Jstn1321/AI-Exoskeleton/BOM.xlsx

Name of Part | In use? | Link | Price | Bought?
Shoulder - Nema 23 50:1 Planetary Gearbox |  | https://www.omc-stepperonline.com/nema-23-closed-loop-stepper-motor-l-78mm-gear-ratio-50-1-high-precision-planetary-gearbox-23hs22-hg50-e1000 | 74.14 | Yes
Shoulder Rotation - Nema 23 20:1 |  | https://www.omc-stepperonline.com/nema-23-closed-loop-stepper-motor-l-77mm-gear-ratio-20-1-high-precision-planetary-gearbox-23hs22-hg20-e1000 | 73.28
Elbow - Nema 23 20:1 |  | https://www.omc-stepperonline.com/nema-23-closed-loop-stepper-motor-l-77mm-gear-ratio-20-1-high-precision-planetary-gearbox-23hs22-hg20-e1000 | 73.28
Forearm rot - Nema 17 20:1 |  | https://www.omc-stepperonline.com/nema-17-closed-loop-stepper-motor-l-39mm-gear-ratio-20-1-high-precision-planetary-gearbox-17hs15-hg20-e1000 | 55.75
Wrist Rot - Nema 17 20:1 |  | https://www.omc-stepperonline.com/nema-17-closed-loop-stepper-motor-l-39mm-gear-ratio-20-1-high-precision-planetary-gearbox-17hs15-hg20-e1000 | 55.75
Shoulder Bearing - LM104949/11 * 2 |  | https://www.amazon.com/dp/B0B5XQK5H1?ref=ppx_yo2ov_dt_b_fed_asin_title&th=1 | 31.58 | Yes
Shoulder Rot Bearing - SET37 * 2 |  | https://www.amazon.com/Timken-SET37-Tapered-Roller-Bearing/dp/B000BZ6YEK?s=industrial | 35.36 | Yes
Elbow Bearing - 2788/2720 * 2 |  | https://www.amazon.com/uxcell-Tapered-Roller-Bearing-Width/dp/B0B5XQX2RD | 22.49 | Yes
Forearm Bearing - 6812-2RS |  | https://www.amazon.com/uxcell-6806-2RS-Groove-Bearings-Double/dp/B082PSBTLP | 14.09 | Yes
Wrist Bearing - 6706-2RS |  | https://www.amazon.com/uxcell-6806-2RS-Groove-Bearings-Double/dp/B082PS9PHD | 8.49 | Yes
Shoulder Rot Belt - 6484K701 |  | https://www.mcmaster.com/6484K701/ | 18.62 | Yes
Limit switches |  | https://www.amazon.com/JANDECCN-Switch-Straight-Action-V-153-1C25/dp/B09SWCJ8FF | 9.99
Position Tracker - BNO055 |  | https://www.amazon.com/Adafruit-Absolute-Orientation-Fusion-Breakout/dp/B017PEIGIG | 42.14
Teensy 4.1 |  | https://www.amazon.com/PJRC-Teensy-4-1-with-Pins/dp/B08CTM3279?s=electronics | 44.15 | Yes
Teensy 4.1 Breakout Board |  | https://www.amazon.com/Terminal-Breakout-Module-Teensy-Version/dp/B08R7P8G9X | 23.9 | Yes
