Jstn1321/AI-Exoskeleton/CAD Models/Back/InnerBearingShaft.SLDPRT

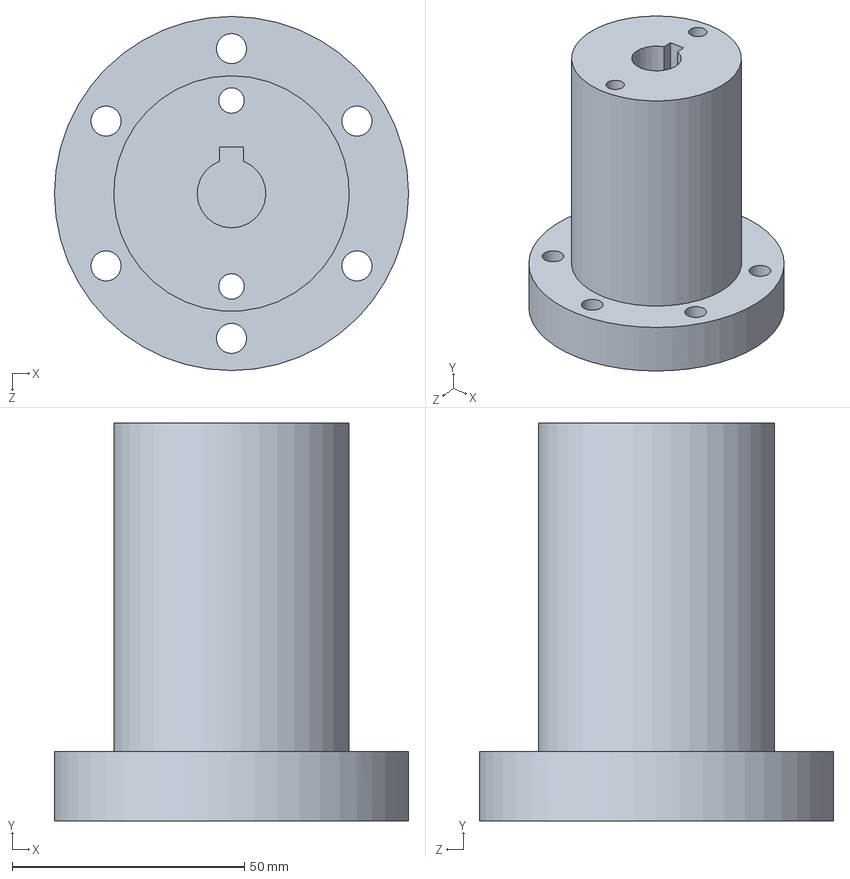
[picture p1: CAD file, 2025-07-13]
CAD Models/Back/InnerBearingShaft.SLDPRT
76.2 x 85.6 x 76.2 mm
