Jstn1321/AI-Exoskeleton/CAD Models/Elbow/MotorElbowCap.SLDPRT

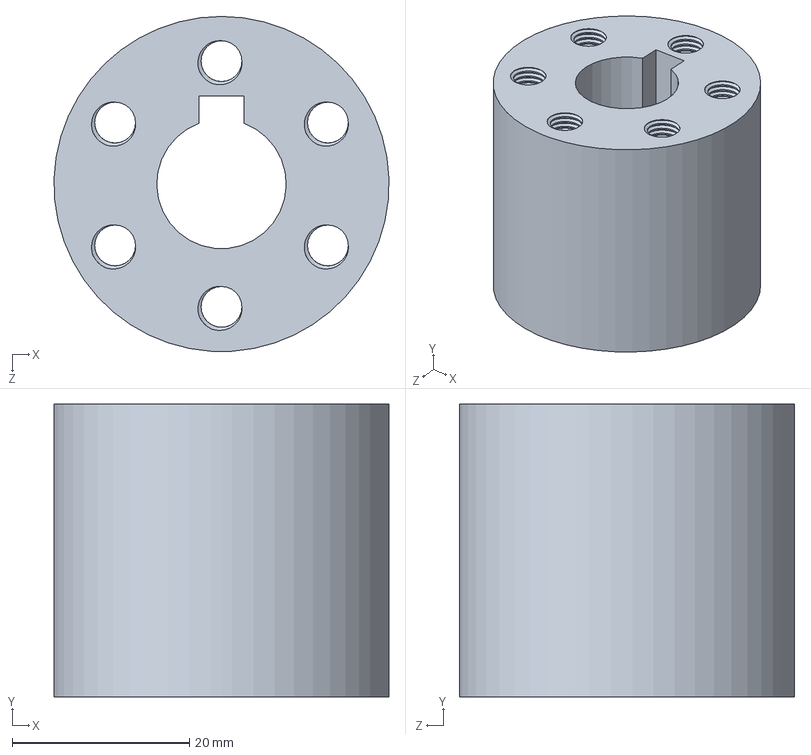
[picture p2: CAD file, 2025-09-02]
CAD Models/Elbow/MotorElbowCap.SLDPRT
37.8 x 33.0 x 37.8 mm
