Jstn1321/AI-Exoskeleton/CAD Models/Forearms/BottomHalfOfForearm.SLDPRT

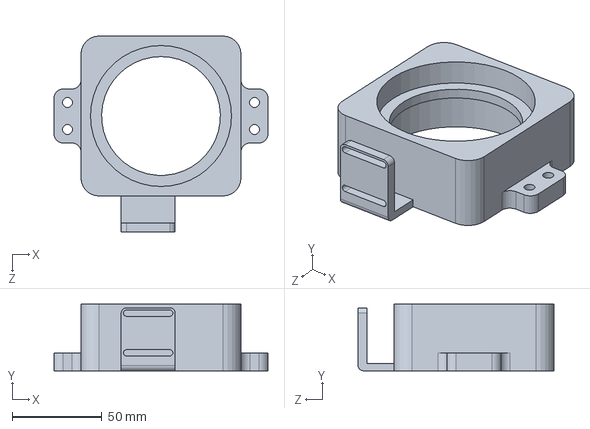
[picture p3: CAD file, 2025-07-11]
CAD Models/Forearms/BottomHalfOfForearm.SLDPRT
118.9 x 37.0 x 108.9 mm
