Jstn1321/AI-Exoskeleton/CAD Models/Hand/Hand.SLDPRT

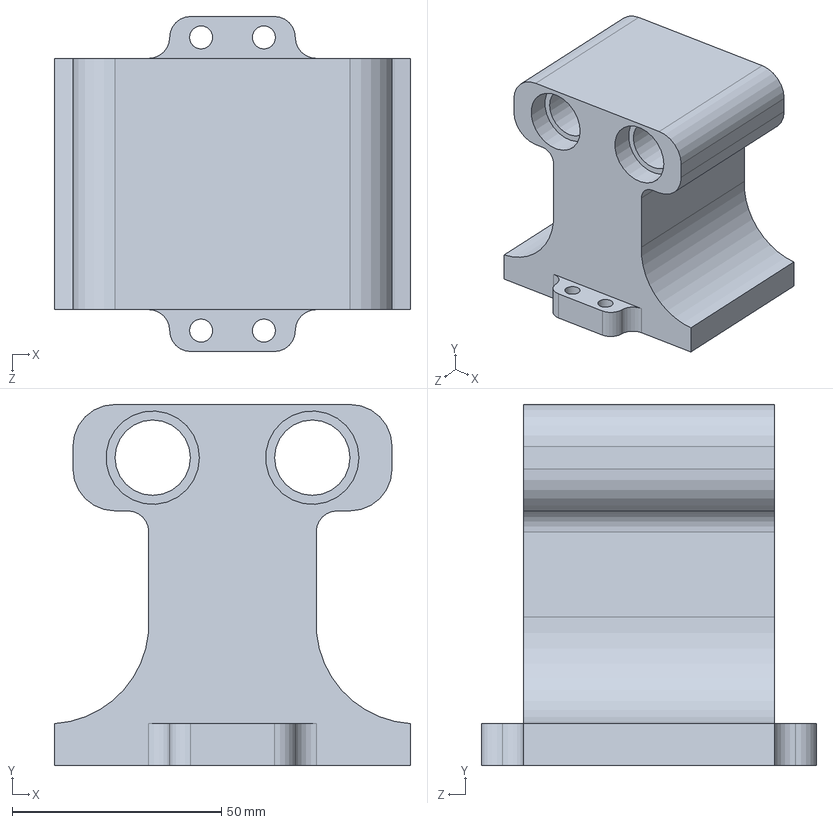
[picture p4: CAD file, 2025-07-19]
CAD Models/Hand/Hand.SLDPRT
85.0 x 86.2 x 80.0 mm
