Jstn1321/AI-Exoskeleton/CAD Models/Misc/LimitSwitchThread.SLDPRT

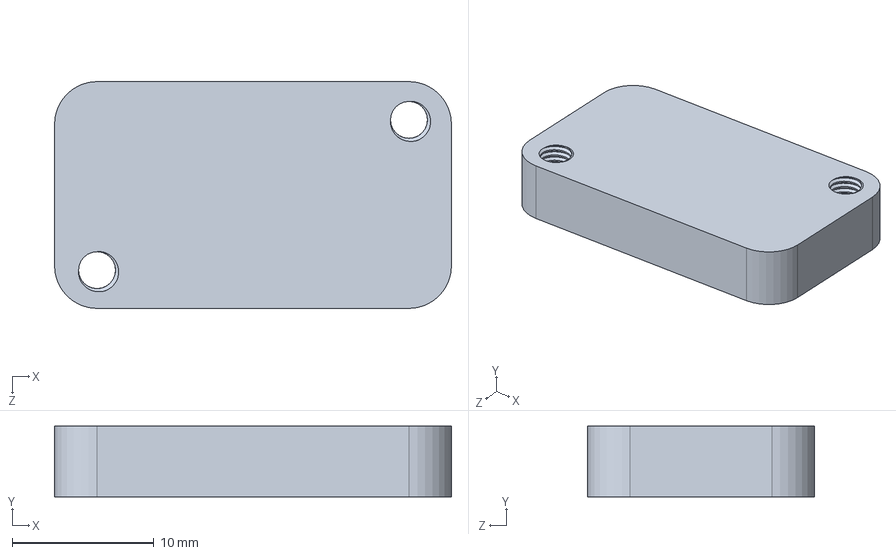
[picture p5: CAD file, 2025-07-05]
CAD Models/Misc/LimitSwitchThread.SLDPRT
28.0 x 5.00 x 16.0 mm
