Jstn1321/AI-Exoskeleton/CAD Models/Shoulder/OuterBearingShaft.SLDPRT

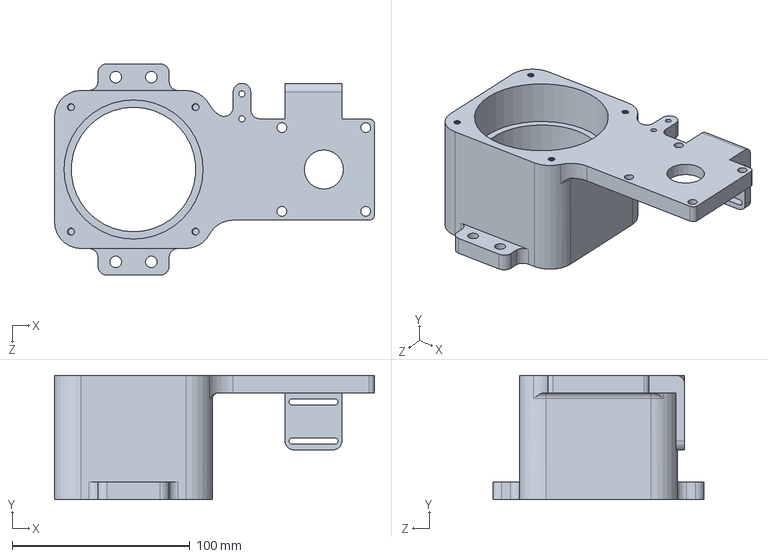
[picture p6: CAD file, 2025-08-18]
CAD Models/Shoulder/OuterBearingShaft.SLDPRT
180.0 x 70.0 x 118.9 mm
