Jstn1321/AI-Exoskeleton/CAD Models/Wrist/Wrist.SLDPRT

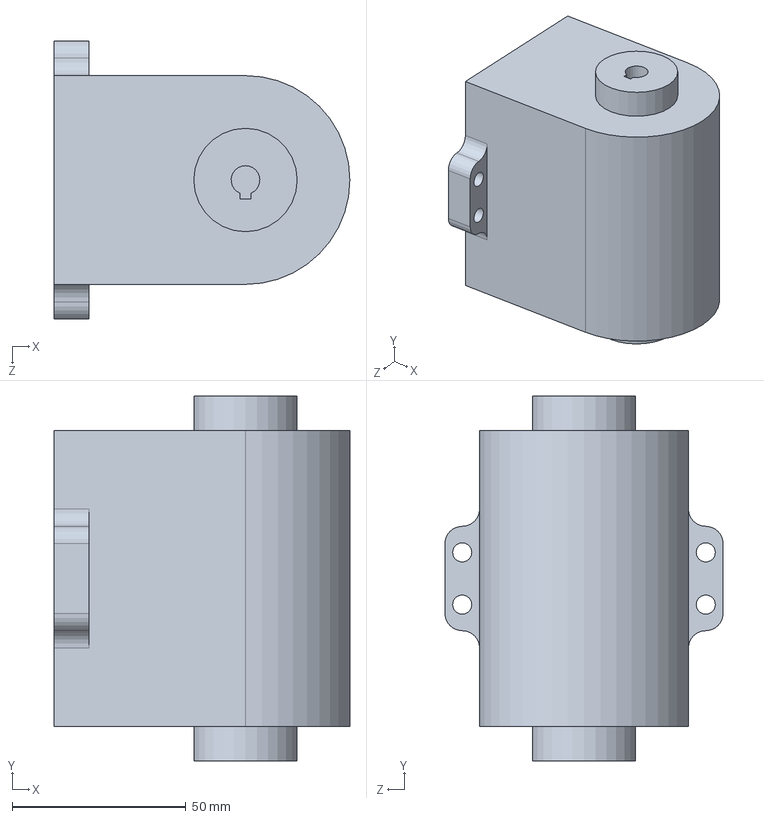
[picture p7: CAD file, 2025-07-11]
CAD Models/Wrist/Wrist.SLDPRT
85.0 x 104.9 x 80.0 mm
