Jstn1321/AI-Exoskeleton/CAD Models/Back/ShoulderMount.SLDPRT

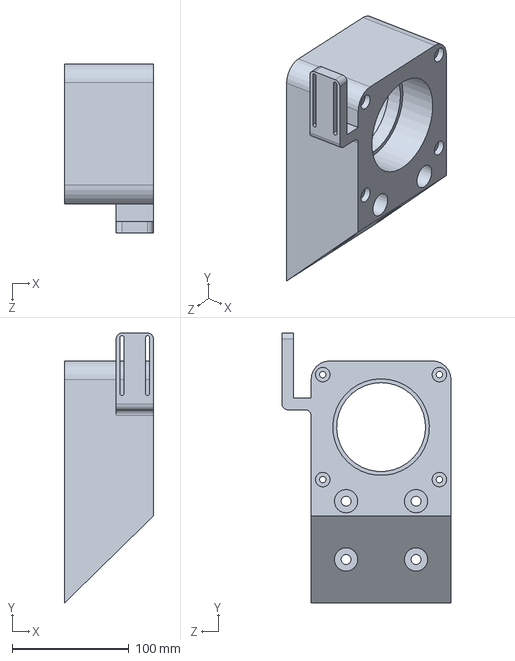
[picture p8: CAD file, 2025-07-01]
CAD Models/Back/ShoulderMount.SLDPRT
76.2 x 231.5 x 145.0 mm
