Jstn1321/AI-Exoskeleton/CAD Models/Elbow/ElbowJointHolderSLDPRT.SLDPRT

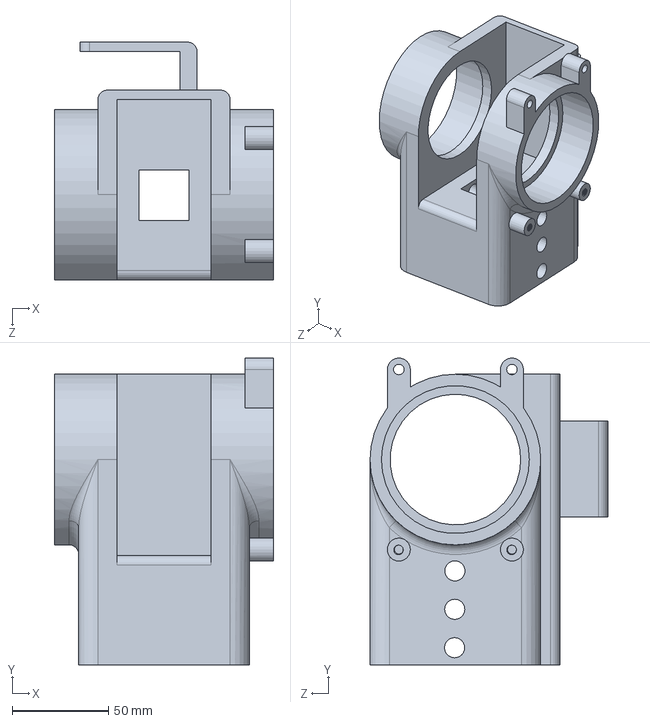
[picture p9: CAD file, 2025-08-29]
CAD Models/Elbow/ElbowJointHolderSLDPRT.SLDPRT
114.3 x 159.9 x 123.9 mm
