Jstn1321/AI-Exoskeleton/CAD Models/Forearms/UpperHalfOfForearm.SLDPRT

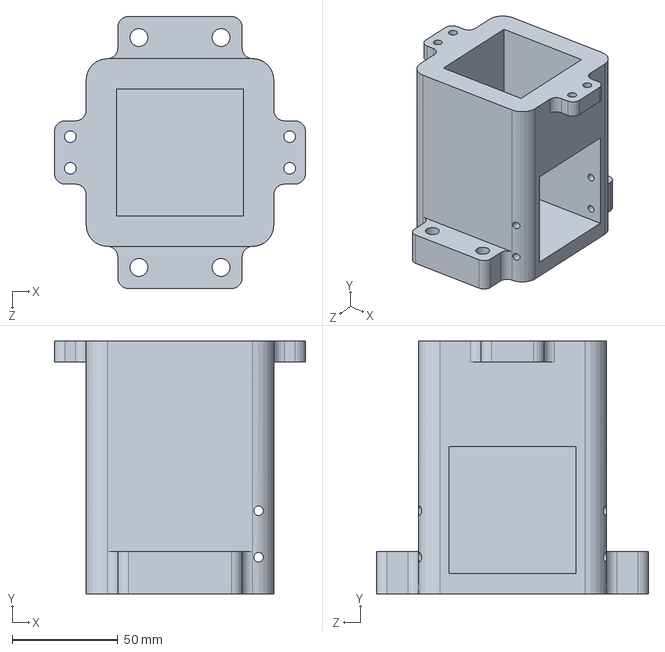
[picture p10: CAD file, 2025-07-11]
CAD Models/Forearms/UpperHalfOfForearm.SLDPRT
118.9 x 119.8 x 128.9 mm
