Jstn1321/AI-Exoskeleton/CAD Models/Shoulder/OuterTensionerRing.SLDPRT

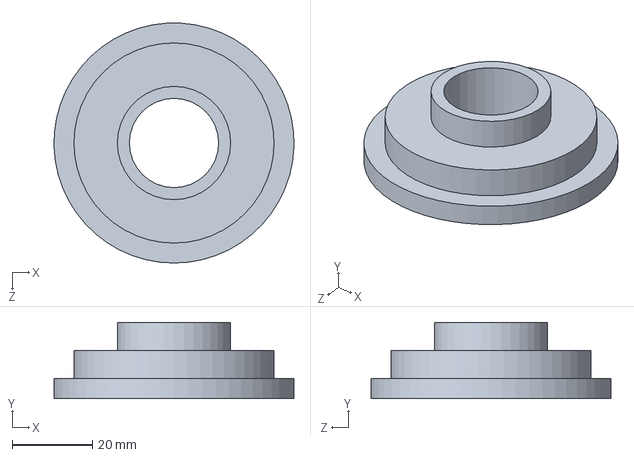
[picture p11: CAD file, 2025-08-03]
CAD Models/Shoulder/OuterTensionerRing.SLDPRT
60.0 x 19.0 x 60.0 mm
