Jstn1321/AI-Exoskeleton/CAD Models/Wrist/WristMotorMount.SLDPRT

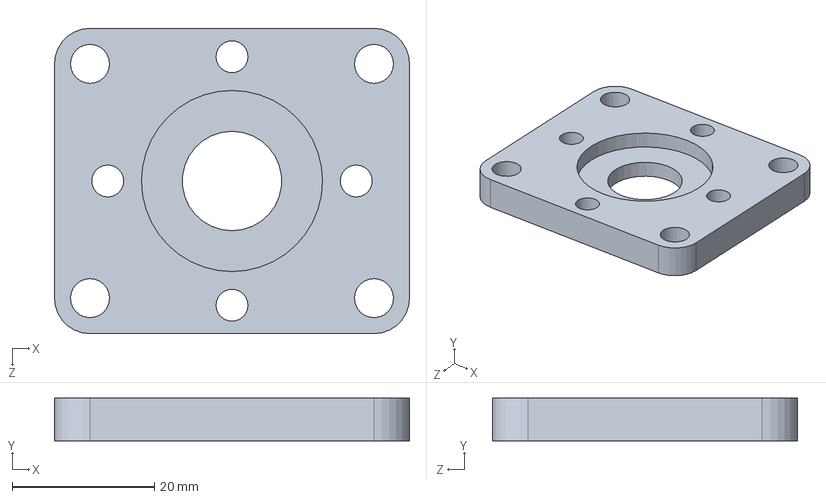
[picture p12: CAD file, 2025-07-11]
CAD Models/Wrist/WristMotorMount.SLDPRT
50.0 x 6.00 x 43.0 mm
