Jstn1321/AI-Exoskeleton/CAD Models/Back/ShoulderLock.SLDPRT

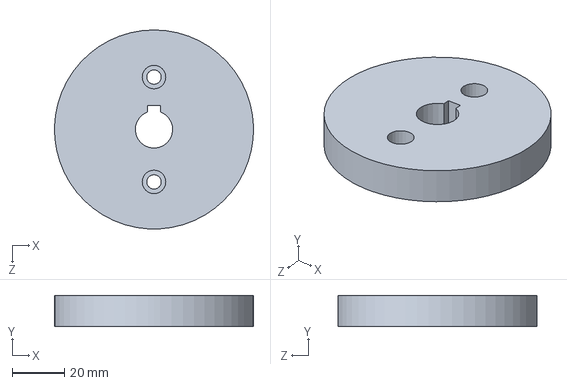
[picture p13: CAD file, 2025-06-28]
CAD Models/Back/ShoulderLock.SLDPRT
76.0 x 12.0 x 76.0 mm
