Jstn1321/AI-Exoskeleton/CAD Models/Elbow/ElbowJoint.SLDPRT

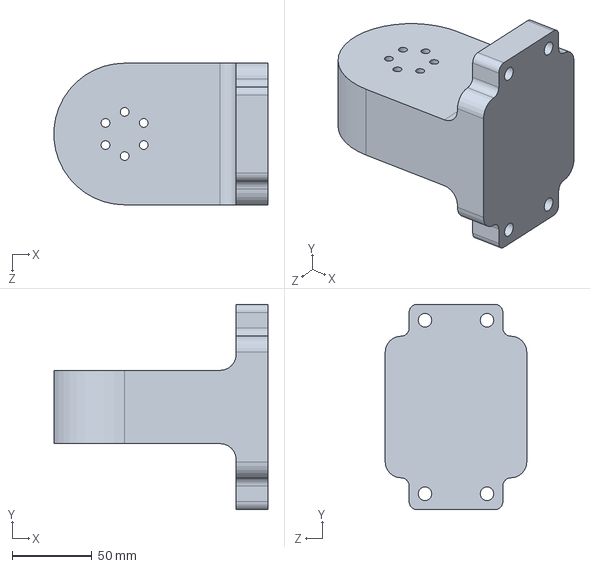
[picture p14: CAD file, 2025-07-11]
CAD Models/Elbow/ElbowJoint.SLDPRT
134.3 x 128.9 x 88.9 mm
