Jstn1321/AI-Exoskeleton/CAD Models/Forearms/InnerShaft.SLDPRT

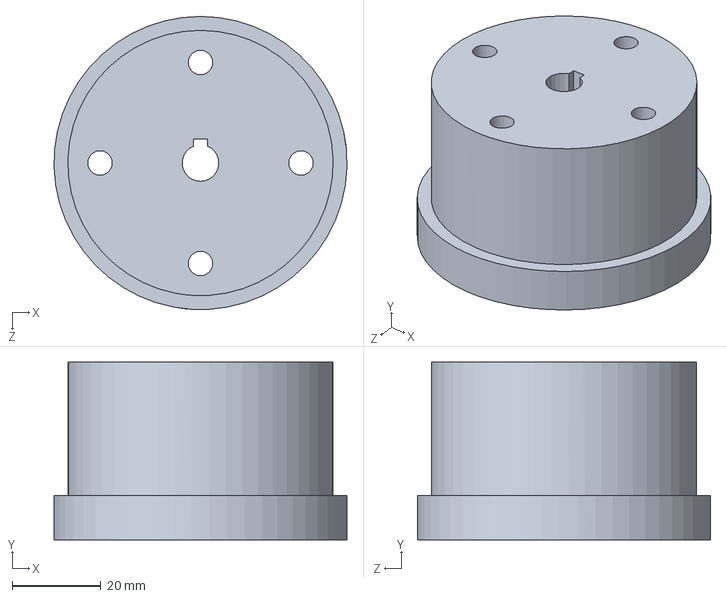
[picture p15: CAD file, 2025-06-27]
CAD Models/Forearms/InnerShaft.SLDPRT
66.0 x 40.0 x 66.0 mm
