Jstn1321/AI-Exoskeleton/CAD Models/Shoulder/GearForMotorShoulderRot.SLDPRT

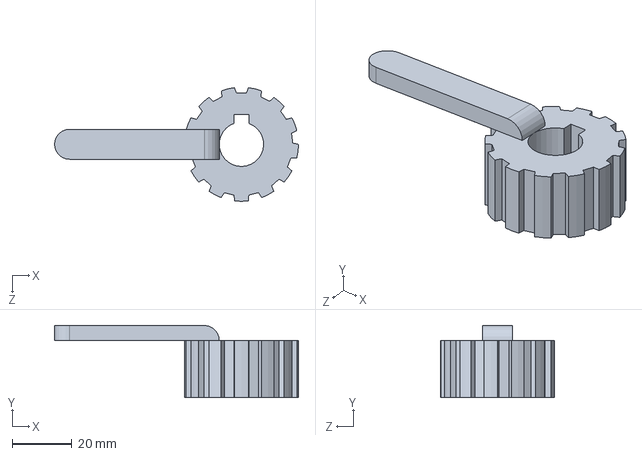
[picture p16: CAD file, 2025-07-13]
CAD Models/Shoulder/GearForMotorShoulderRot.SLDPRT
81.4 x 24.0 x 38.0 mm
