Jstn1321/AI-Exoskeleton/CAD Models/Wrist/MotorSideBearingHolder.SLDPRT

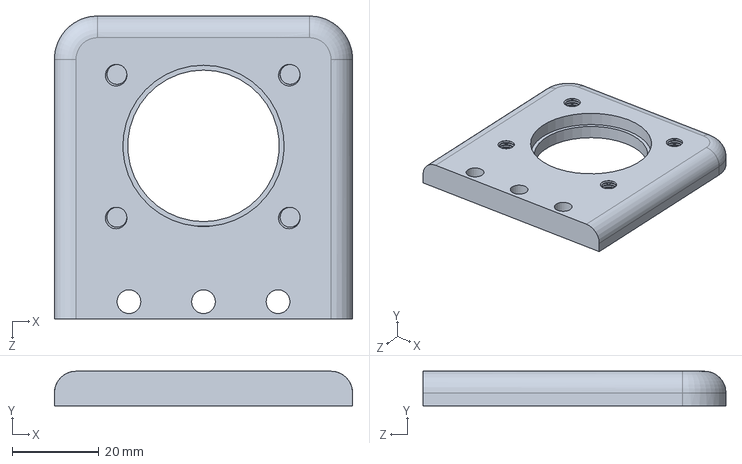
[picture p17: CAD file, 2025-07-11]
CAD Models/Wrist/MotorSideBearingHolder.SLDPRT
68.9 x 8.00 x 70.0 mm
