Jstn1321/AI-Exoskeleton/CAD Models/Back/ShoulderMotorAdaptor.SLDPRT

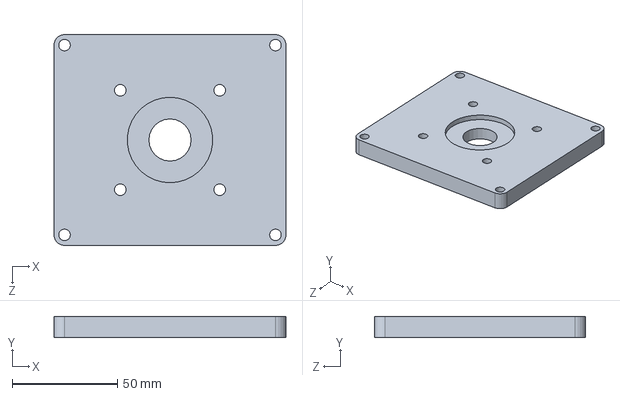
[picture p18: CAD file, 2025-05-29]
CAD Models/Back/ShoulderMotorAdaptor.SLDPRT
110.0 x 10.0 x 100.0 mm
