Jstn1321/AI-Exoskeleton/CAD Models/Elbow/NonMotorElbowCap.SLDPRT

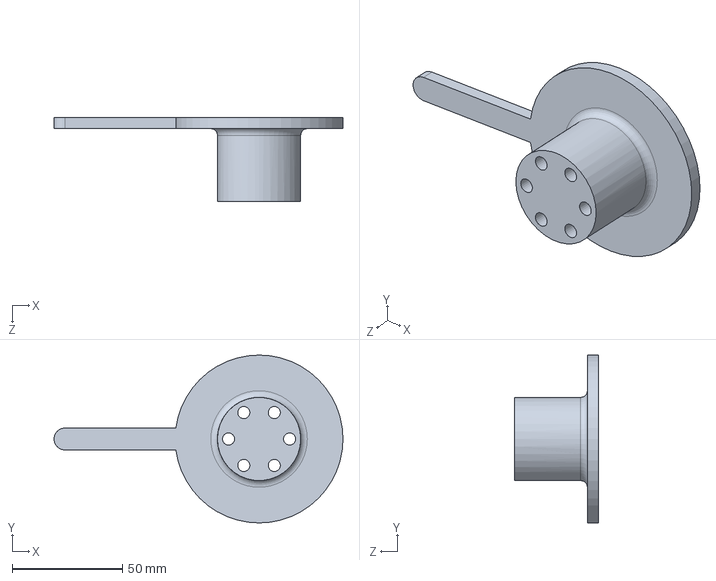
[picture p19: CAD file, 2025-07-06]
CAD Models/Elbow/NonMotorElbowCap.SLDPRT
131.2 x 76.2 x 38.0 mm
