Jstn1321/AI-Exoskeleton/CAD Models/Forearms/MotorMountForForearm.SLDPRT

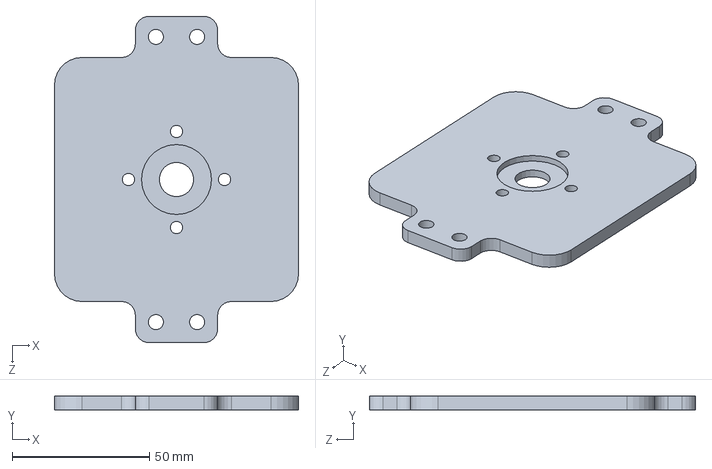
[picture p20: CAD file, 2025-06-26]
CAD Models/Forearms/MotorMountForForearm.SLDPRT
88.9 x 5.00 x 118.9 mm
