Jstn1321/AI-Exoskeleton/CAD Models/Shoulder/GearForShaftShoulderRot.SLDPRT

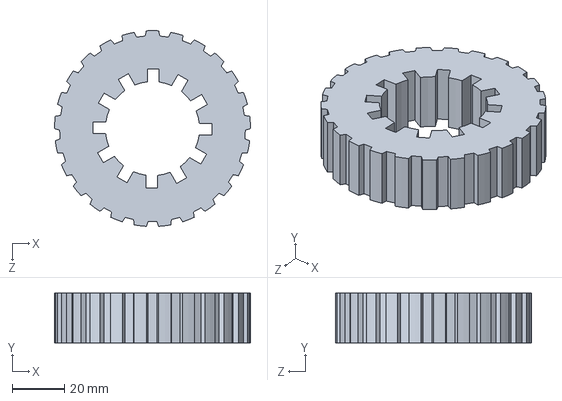
[picture p21: CAD file, 2025-07-13]
CAD Models/Shoulder/GearForShaftShoulderRot.SLDPRT
74.9 x 19.1 x 74.9 mm
