Jstn1321/AI-Exoskeleton/CAD Models/Wrist/LimitSideBearingHolder.SLDPRT

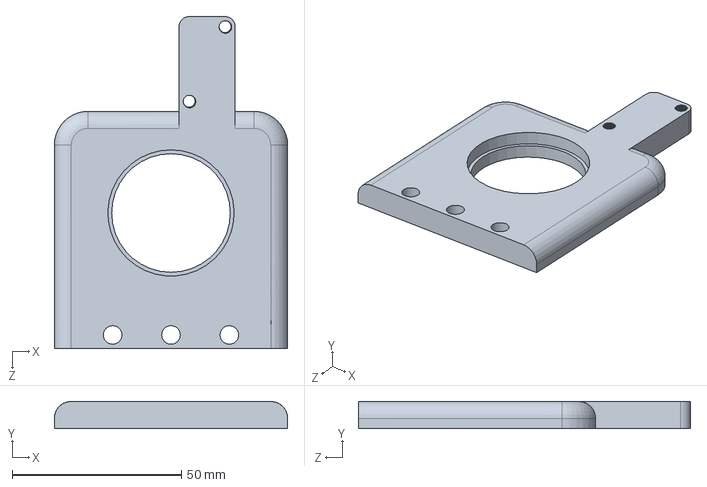
[picture p22: CAD file, 2025-07-11]
CAD Models/Wrist/LimitSideBearingHolder.SLDPRT
68.9 x 8.00 x 98.0 mm
