Jstn1321/AI-Exoskeleton/CAD Models/Back/BackHousing.SLDPRT

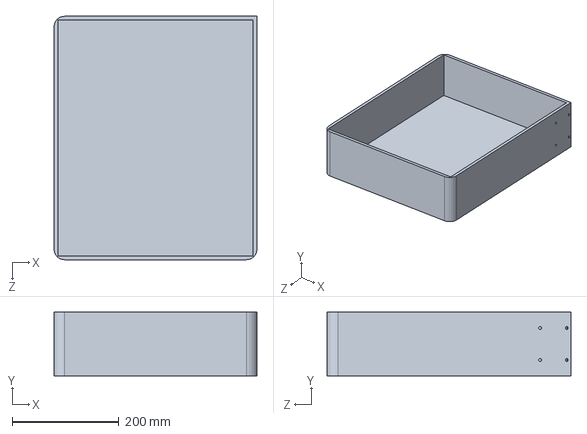
[picture p23: CAD file, 2025-05-29]
CAD Models/Back/BackHousing.SLDPRT
381.0 x 120.0 x 457.2 mm
