Jstn1321/AI-Exoskeleton/CAD Models/Elbow/MotorMount.SLDPRT

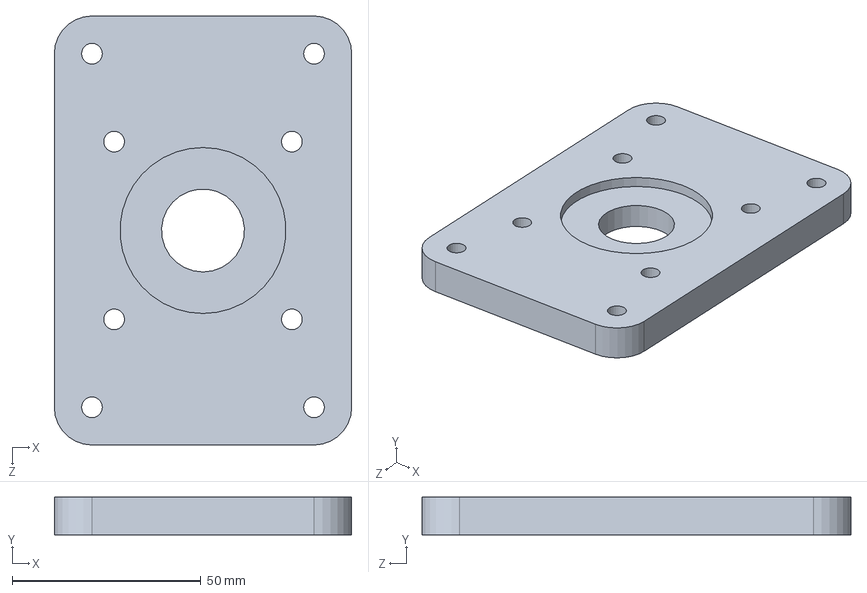
[picture p24: CAD file, 2025-06-17]
CAD Models/Elbow/MotorMount.SLDPRT
78.9 x 10.0 x 113.8 mm
