Jstn1321/AI-Exoskeleton/CAD Models/Shoulder/InnerBearingShaftShoulder.SLDPRT

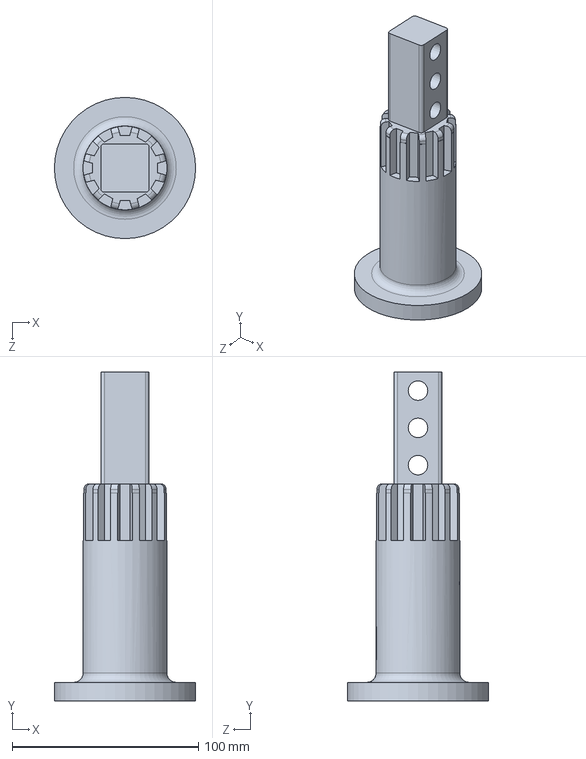
[picture p25: CAD file, 2025-07-08]
CAD Models/Shoulder/InnerBearingShaftShoulder.SLDPRT
75.8 x 176.6 x 75.8 mm
