Jstn1321/AI-Exoskeleton/CAD Models/Wrist/WristHolder.SLDPRT

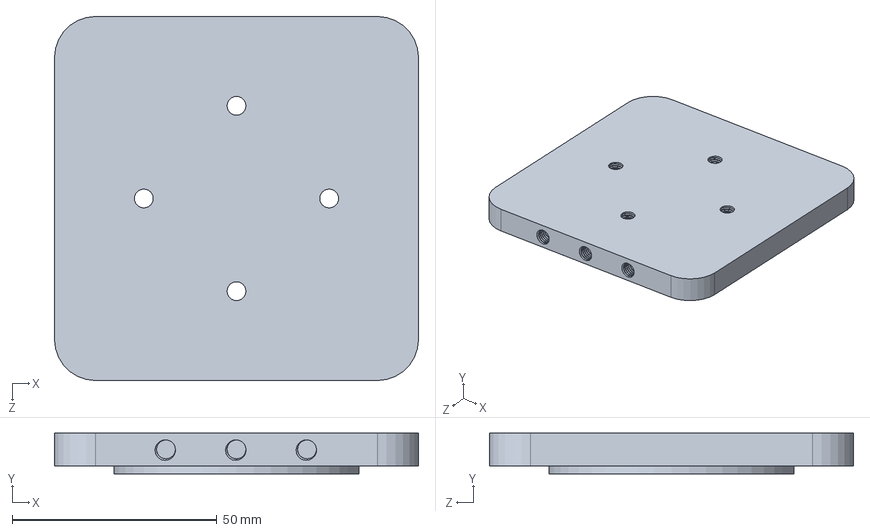
[picture p26: CAD file, 2025-07-11]
CAD Models/Wrist/WristHolder.SLDPRT
88.9 x 10.0 x 88.9 mm
