Jstn1321/AI-Exoskeleton/CAD Models/Shoulder/TopBearingLock.SLDPRT

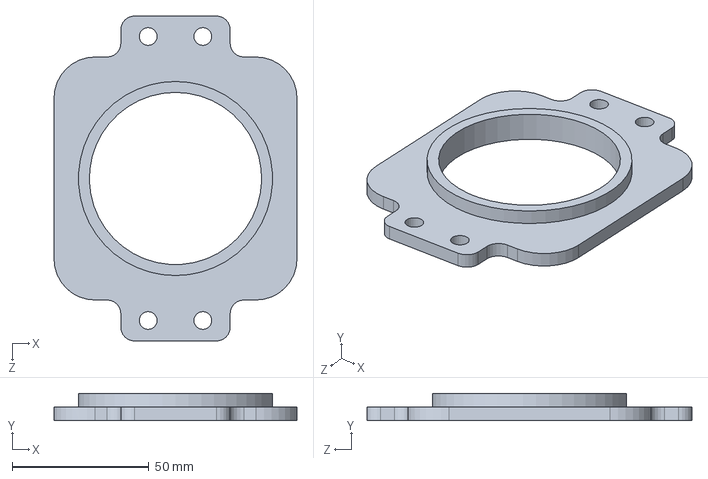
[picture p27: CAD file, 2025-07-07]
CAD Models/Shoulder/TopBearingLock.SLDPRT
88.9 x 10.0 x 118.9 mm
