Jstn1321/AI-Exoskeleton/CAD Models/Wrist/LimitSwtichHitterJ4.SLDPRT

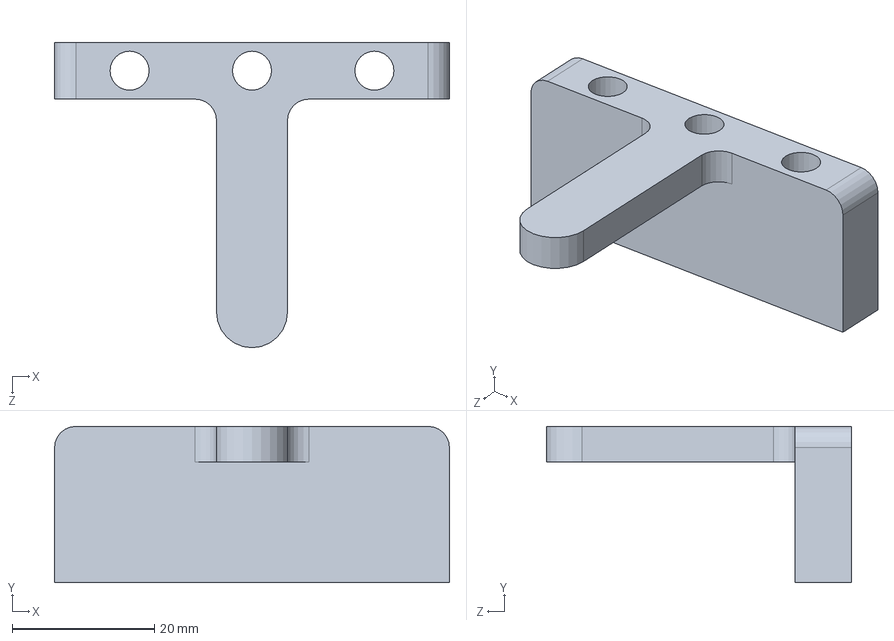
[picture p28: CAD file, 2025-07-11]
CAD Models/Wrist/LimitSwtichHitterJ4.SLDPRT
55.6 x 22.0 x 43.0 mm
