Jstn1321/AI-Exoskeleton/CAD Models/Shoulder/ShoulderRotBearingLock.SLDPRT

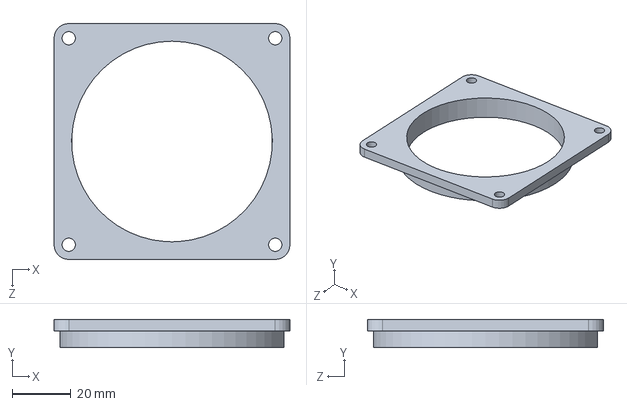
[picture p29: CAD file, 2025-07-05]
CAD Models/Shoulder/ShoulderRotBearingLock.SLDPRT
80.0 x 9.56 x 80.0 mm
