Jstn1321/AI-Exoskeleton/CAD Models/Wrist/LimitSwitchHitterForWrist.SLDPRT

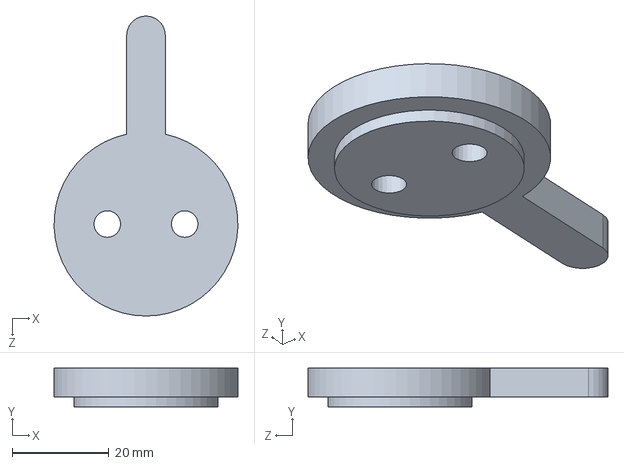
[picture p30: CAD file, 2025-06-28]
CAD Models/Wrist/LimitSwitchHitterForWrist.SLDPRT
38.0 x 8.00 x 62.0 mm
