Jstn1321/AI-Exoskeleton/CAD Models/Shoulder/BeltTensionerForShoulderRot.SLDPRT

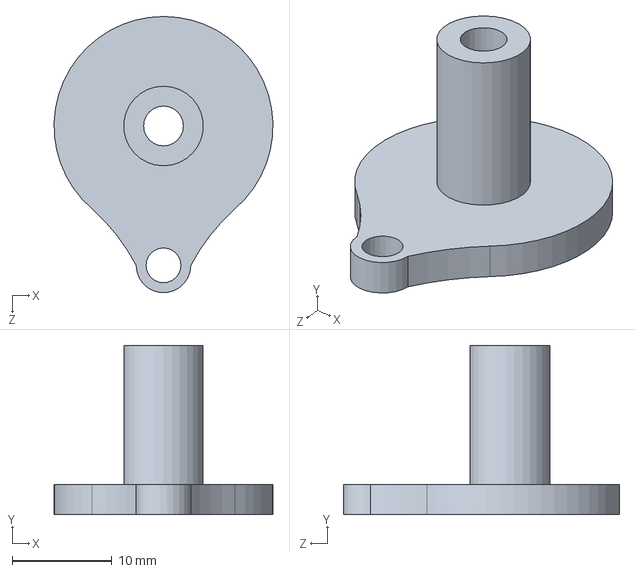
[picture p31: CAD file, 2025-07-03]
CAD Models/Shoulder/BeltTensionerForShoulderRot.SLDPRT
22.0 x 17.0 x 27.7 mm
