Jstn1321/AI-Exoskeleton/CAD Models/Shoulder/TopHalfOfShoulder.SLDPRT

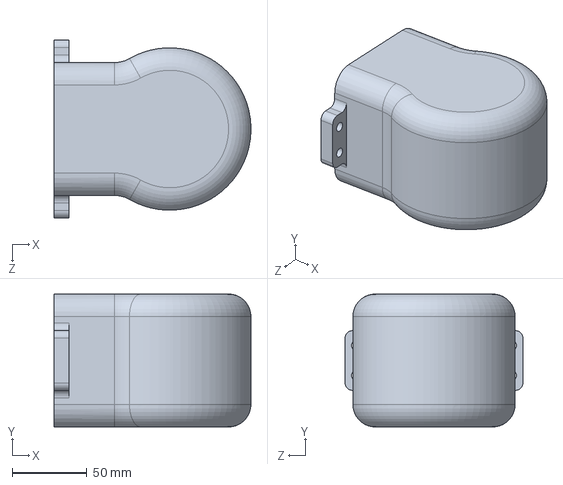
[picture p32: CAD file, 2025-06-27]
CAD Models/Shoulder/TopHalfOfShoulder.SLDPRT
131.7 x 88.9 x 118.9 mm
