Jstn1321/AI-Exoskeleton/CAD Models/FullExoskeletonAsm.SLDASM

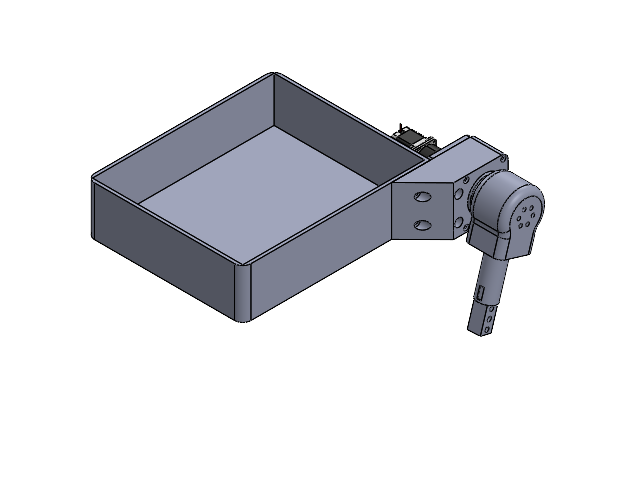
[picture p33: CAD file, 2025-06-04]
CAD Models/FullExoskeletonAsm.SLDASM
BackHousing
ShoulderMotorAdaptor
ShoulderMount
23HS22-2804S-HG100.step
5709K91_Tapered-Roller Bearing with Steel Ring(1) x 2
InnerBearingShaftTOBECNCed
TopHalfOfShoulder
InnerBearingShaftShoulder
