Jstn1321/AI-Exoskeleton/(list of files, cad)

Other CAD files:
CAD Models/McMasterCarr/Bearings/5709K88_Tapered-Roller Bearing with Steel Ring.SLDPRT
CAD Models/McMasterCarr/Bearings/5709K89_Tapered-Roller Bearing with Steel Ring.SLDPRT
CAD Models/McMasterCarr/Bearings/5709K91_Tapered-Roller Bearing with Steel Ring(1).SLDPRT
CAD Models/McMasterCarr/Belts/6484K701_L Series Timing Belt.SLDPRT
