Jstn1321/AI-Exoskeleton/(commit log)

2025-05-26 Added a BOM
    [BOM.xlsx]
2025-05-27 Updated the BOM
    [BOM.xlsx]
2025-05-27 Added a prototype housing for the electronics
    [BackHousing.SLDPRT]
2025-05-27 Made a shoulder mount for the shoulder to the housing
    [ShoulderMount.SLDPRT]
2025-05-27 Made a adaptor for the motor to connect to the shoulder mount
    [ShoulderMotorAdaptor.SLDPRT]
2025-05-27 Updated BOM
    [BOM.xlsx]
2025-05-27 Made an assembly for the exoskeleton
    [FullExoskeletonAsm.SLDASM]
2025-05-27 Added some screw hole cut-outs
    [ShoulderMotorAdaptor.SLDPRT]
2025-05-29 Added more height to the mount so the motor adaptor holes are aligned with the center
    [ShoulderMount.SLDPRT]
2025-05-29 Added a file for the bearing in the shoulder
    [5709K91_Tapered-Roller Bearing with Steel Ring(1).SLDPRT]
2025-05-29 Added bearing and inner bearing shaft
    [FullExoskeletonAsm.SLDASM]
2025-05-29 Added a inner bearing shaft to mount motor with shoulder
    [InnerBearingShaftTOBECNCed.SLDPRT]
2025-05-29 Added another sketch
    [BackHousing.SLDPRT]
2025-05-29 Added some smart dimensions
    [ShoulderMotorAdaptor.SLDPRT]
2025-05-29 Made a file for the top half of the shoulder
    [TopHalfOfShoulder.SLDPRT]
2025-05-31 Added the general shape of the shoulder, need to add the dome and hollow some of it out for the motor and bearings
    [TopHalfOfShoulder.SLDPRT]
2025-06-01 Added the dome and the part for the rotating shaft, may need to cut an area for the motor
    [TopHalfOfShoulder.SLDPRT]
2025-06-01 Updated the assembly for the new top half of the shoulder
    [FullExoskeletonAsm.SLDASM]
2025-06-01 Made a file for the inner bearing
    [InnerBearingShaftShoulder.SLDPRT]
2025-06-01 Updated the assembly
    [FullExoskeletonAsm.SLDASM]
2025-06-02 Added the general shape for the inner bearing. Need to add a key and screw indents at the end for the rest of the arm
    [InnerBearingShaftShoulder.SLDPRT]
2025-06-02 Made the shoulder bigger and got rid of the dome
    [TopHalfOfShoulder.SLDPRT]
2025-06-03 Finished the inner bearing
    [InnerBearingShaftShoulder.SLDPRT]
2025-06-04 Made a file for outer bearing shaft
    [OuterBearingShaft.SLDPRT]
2025-06-04 Updated assembly by adding inner shaft
    [FullExoskeletonAsm.SLDASM]
2025-06-04 Made hole larger to compensate for the 5mm fillet
    [TopHalfOfShoulder.SLDPRT]
2025-06-04 Updated asm for the new changes made to the top half of shoulder
    [FullExoskeletonAsm.SLDASM]
2025-06-04 Made outer bearing but don't know the constraints yet for the bearings but have everything else but the mounting for the motor
    [OuterBearingShaft.SLDPRT]
2025-06-04 Added motor mount and the appropriate distance from the motor to the shaft for a L series belt with a 12.4 inch diameter and 2 inch diameter gears
    [OuterBearingShaft.SLDPRT]
2025-06-04 Added the bearings to be used in the bottom shoulder or J2 joint
    [5709K89_Tapered-Roller Bearing with Steel Ring.SLDPRT]
2025-06-04 Added belt to be used in J2
    [6484K144_L Series Timing Belt.SLDPRT]
2025-06-04 Updated assembly for the bearings, belt, and new shafts and motors
2025-06-04 Added 1:50 stepper motor
    [23HS22-2804D-HG50-AR3.STEP]
2025-06-04 Added the 1:100 stepper motor
    [23HS22-2804S-HG100.STEP]
2025-06-04 Removed belt from assembly for now, will add back when I finish making gears
2025-06-05 Updated the BOM for the shoulder rot motor and its bearings and belt, the shoulder bearings
    [BOM.xlsx]
2025-06-06 Made file for the gear to go on the motor's shaft
    [GearForMotorShoulderRot.SLDPRT]
2025-06-06 Made file for the gear on the arm's shaft
    [GearForShaftShoulderRot.SLDPRT]
2025-06-06 Created general gear shape
    [GearForMotorShoulderRot.SLDPRT, GearForShaftShoulderRot.SLDPRT]
2025-06-06 Changed distance from motor mount to center shaft to account for larger belt and larger than planned gears
    [OuterBearingShaft.SLDPRT]
2025-06-06 Made the key for the shaft
    [KeyForShoulderRot.SLDPRT]
2025-06-06 Made the key double the height
    [KeyForShoulderRot.SLDPRT]
2025-06-06 Made keyhole deeper for larger key
    [InnerBearingShaftShoulder.SLDPRT]
2025-06-06 Added key and shaft hole, also made the gear larger
    [GearForShaftShoulderRot.SLDPRT]
2025-06-06 Made hole 0.2mm wider to account for tolerances
    [InnerBearingShaftShoulder.SLDPRT]
2025-06-06 Changed the belt to a larger one
    [BOM.xlsx]
2025-06-06 Added key shaft to assembly
2025-06-06 Added new belt
    [6484K701_L Series Timing Belt.SLDPRT]
2025-06-06 Deleted old belt
    [6484K144_L Series Timing Belt.SLDPRT]
2025-06-06 Added inner shaft gear
2025-06-06 Created shaft and keyhole
    [GearForMotorShoulderRot.SLDPRT]
2025-06-06 Added motor gear to assembly
2025-06-07 Added a spline coupler for gear
    [InnerBearingShaftShoulder.SLDPRT]
2025-06-08 Added a inner spline coupler
    [InnerBearingShaftShoulder.SLDPRT]
2025-06-08 Added inner spline
    [GearForShaftShoulderRot.SLDPRT]
2025-06-08 Added a belt tensioner
    [OuterBearingShaft.SLDPRT]
2025-06-08 Updated the assembly for the belt tensioner
2025-06-09 Made file for the elbow joint holder, which will have the bearings and motor mount
    [ElbowJointHolderSLDPRT.SLDPRT]
2025-06-14 Changed teeth number so that belt can fit onto gear since it increases the degreee between each tooth
    [GearForMotorShoulderRot.SLDPRT]
2025-06-14 Changed teeth again to 25 as per equation and changed the radius of the gear also according to the equation, increased the width of the extrude cut as well to seat the belt in better hopefully
    [GearForMotorShoulderRot.SLDPRT]
2025-06-14 Changed the tooth depth to prevent bottoming out
    [GearForMotorShoulderRot.SLDPRT]
2025-06-14 Changed tooth profile to match belt, copied from the gear for the motor shaft
    [GearForShaftShoulderRot.SLDPRT]
2025-06-15 Changed the diameter to fit the bearing better
    [ShoulderMount.SLDPRT]
2025-06-15 Changed diameter of inner bearing to fit snug
    [InnerBearingShaftTOBECNCed.SLDPRT]
2025-06-17 Added the square coupler and added the circular shape at the end
    [ElbowJointHolderSLDPRT.SLDPRT]
2025-06-17 Added bearing holders
    [ElbowJointHolderSLDPRT.SLDPRT]
2025-06-17 Added holes for the motor
    [ElbowJointHolderSLDPRT.SLDPRT]
2025-06-17 Created the motor mount
    [MotorMount.SLDPRT]
2025-06-17 Updated assembly to match new parts
2025-06-17 Changed the fillet to be more thicker and have a tamer fillet
    [ElbowJointHolderSLDPRT.SLDPRT]
2025-06-17 Added the cap for the elbow joint on the non motor moutned side
    [NonMotorElbowCap.SLDPRT]
2025-06-17 Added elbow cap for the motor mounted side
    [MotorElbowCap.SLDPRT]
2025-06-17 Added placement bearing to be used in the elbow joint
    [5709K88_Tapered-Roller Bearing with Steel Ring.SLDPRT]
2025-06-17 Made the part longer so it can touch both the end of the bearing and the inner elbow joint
    [MotorElbowCap.SLDPRT]
2025-06-17 Added bearing into assembly
    [5709K88_Tapered-Roller Bearing with Steel Ring.SLDPRT]
2025-06-17 Fully updated the assembly to match new components being made like the two elbow caps
2025-06-18 Added elbow bearings into BOM
    [BOM.xlsx]
2025-06-19 Added elbow joint - before creating adaptor for forearm and up
    [ElbowJoint.SLDPRT]
2025-06-19 Fixed motor cap so the extruded cut actually goes through the entire model
    [MotorElbowCap.SLDPRT]
2025-06-19 Added motor shaft hole
    [MotorElbowCap.SLDPRT]
2025-06-19 Changed hexagon inner circle to 12 because motor shaft is too big for 10mm
    [MotorElbowCap.SLDPRT]
2025-06-19 Changed hexagon inner circle from 10mm to 12mm because motor shaft is too large for 10 mm
    [ElbowJoint.SLDPRT]
2025-06-19 Rebuilt assembly for new changes
2025-06-19 Added elbow motor
2025-06-19 Added forearm adaptor section
    [ElbowJoint.SLDPRT]
2025-06-19 Added screw holes and a coupler at the end of the elbow joint
    [ElbowJoint.SLDPRT]
2025-06-19 Made the elbow joint a little bit longer because it was too short and hitting the elbow joint holder
    [ElbowJoint.SLDPRT]
2025-06-19 Rebuilt exoskeleton for new elbow joint
2025-06-19 Made it so that the limit switch hitter is aligned with the holes on the non motor cap
    [NonMotorElbowCap.SLDPRT]
2025-06-19 Made the indent on the elbow joint holder larger so the elbow joint can rotate a full 180 degrees
    [ElbowJointHolderSLDPRT.SLDPRT]
2025-06-19 Updated the assembly to match new changes
2025-06-22 Made the forearm file
    [Forearm.SLDPRT]
2025-06-23 Finished the full forearm shape but need to add hand adaptor
    [Forearm.SLDPRT]
2025-06-23 Updated elbow joint
    [ElbowJoint.SLDPRT]
2025-06-23 Rebuilt assembly to include forearm and added appropriate mates
2025-06-23 Made the angle the foreman came in smaller
    [Forearm.SLDPRT]
2025-06-23 Made the coupling hole on the other side
    [ElbowJoint.SLDPRT]
2025-06-23 Moved hole on other side to prevent the four mounting holes from interfering with the coupling hole
    [Forearm.SLDPRT]
2025-06-23 Unsuppressed fillet
    [Forearm.SLDPRT]
2025-06-23 Added some tolerance
    [Forearm.SLDPRT]
2025-06-23 Added both mounting holes and the coupleing hole
    [Forearm.SLDPRT]
2025-06-23 Rebuilt assembly with new changes on forearm
2025-06-23 Changed folder name to forearms
    [Forearm.SLDPRT]
2025-06-23 Changed forearm name to lifting forearm
    [LiftingForearm.SLDPRT]
2025-06-24 Created file for the hand for heavy lifting
    [RigidHand.SLDPRT]
2025-06-25 Added limit switch mount
    [ShoulderMount.SLDPRT]
2025-06-25 Rebuilt assembly for limit switch mount on shoulder
2025-06-25 Added fillets on the limit switch mount to make it look better and stronger
    [ShoulderMount.SLDPRT]
2025-06-25 Added limit switch hitter
    [GearForMotorShoulderRot.SLDPRT]
2025-06-25 Added other mounting holes
    [OuterBearingShaft.SLDPRT]
2025-06-25 Removed the other four mounting holes
    [OuterBearingShaft.SLDPRT]
2025-06-25 Forgot to add the other two mounting hole so I added them
    [OuterBearingShaft.SLDPRT]
2025-06-25 Removed nonlogical mounting holes
    [TopHalfOfShoulder.SLDPRT]
2025-06-25 Moved hand and renamed rigid hand to a hand folder
    [Hand.SLDPRT, TopHalfOfShoulder.SLDPRT]
2025-06-25 Removed circular extrusion and added the 6 M6 screws for the inner shaft adn the two M5 screws for the lock on the inner shaft
    [TopHalfOfShoulder.SLDPRT]
2025-06-25 Removed the 6 holes on the inner shaft and added them to the outer ring and added the 2 M5 screws for the locking mechanism
    [InnerBearingShaftTOBECNCed.SLDPRT]
2025-06-25 Added fillet on the other edge
    [ShoulderMount.SLDPRT]
2025-06-25 Made a file for the shoulder lock
    [ShoulderLock.SLDPRT]
2025-06-25 Removed sketch that was causing rebuild errors
    [ShoulderMount.SLDPRT]
2025-06-25 Made the shoulder lock
    [ShoulderLock.SLDPRT]
2025-06-25 Shrunk the length of the shaft to fit the shoulder lock
    [InnerBearingShaftTOBECNCed.SLDPRT]
2025-06-25 Widened gap from shoulder screw hole lock from 15mm to 20mm
    [InnerBearingShaftTOBECNCed.SLDPRT]
2025-06-25 Changed shoulder lock screw holes from 15mm to 20mm
    [ShoulderLock.SLDPRT, TopHalfOfShoulder.SLDPRT]
2025-06-25 Widened motor hole and created screw head holes to make the M5 screws flush with the shoulder lock
    [ShoulderLock.SLDPRT]
2025-06-25 Rebuilt exoskeleton assembly according to the new changes made
2025-06-26 Shrunk outer diameter
    [ShoulderLock.SLDPRT]
2025-06-26 Updated the BOM for screws and limit switches
    [BOM.xlsx]
2025-06-26 Added an extra screw hole for the bearing to make it tighter
    [OuterBearingShaft.SLDPRT]
2025-06-26 Removed the key cause it isn't necessary
    [KeyForShoulderRot.SLDPRT]
2025-06-26 Added a belt tensioner for the shoulder rotation
    [BeltTensionerForShoulderRot.SLDPRT]
2025-06-26 Added a threaded screw hole in addition to the other screw hole to make it tighter and more sturdy
    [OuterBearingShaft.SLDPRT]
2025-06-26 Removed the gap between the screw holes
    [ElbowJoint.SLDPRT, LiftingForearm.SLDPRT]
2025-06-26 Updated the BOM by adding in bearings and new motors
    [BOM.xlsx]
2025-06-26 Renamed file to upper forearm
    [LiftingForearm.SLDPRT]
2025-06-26 Made a new file for the bottom half of forearm and created the all the bearing inserts
    [BottomHalfOfForearm.SLDPRT]
2025-06-26 Created file for the inner shaft for the forearm rotation and add all of the inner bearing inserts
    [InnerShaft.SLDPRT]
2025-06-26 Added forearm motor
2025-06-26 Made file for the upper forearm
    [UpperHalfOfForearm.SLDPRT]
2025-06-26 Created the motor mount for the forearm motor to keep the motor in the forearm
    [MotorMountForForearm.SLDPRT]
2025-06-27 Created the base and moutning holes for the wrist
    [WristHolder.SLDPRT]
2025-06-27 Changed screw depth because it was on the blind setting instead of up to surface
    [ElbowJointHolderSLDPRT.SLDPRT, TopHalfOfShoulder.SLDPRT]
2025-06-27 Created the screw holes for the wrist bearing frames
    [WristHolder.SLDPRT]
2025-06-27 Made file for the bearing holder for the motor side
    [MotorSideBearingHolder.SLDPRT]
2025-06-27 Made file for the limit switch side of the bearing holder
    [LimitSideBearingHolder.SLDPRT]
2025-06-27 Made file for the motor mount
    [WristMotorMount.SLDPRT]
2025-06-27 Updated the BOM with wrist bearing and motor
    [BOM.xlsx]
2025-06-27 Added all of the screw holes for the motor and the mounting holes
    [WristMotorMount.SLDPRT]
2025-06-27 Added the screw holes for the motor mount
    [MotorSideBearingHolder.SLDPRT]
2025-06-27 Changed the size of the wrist holder to match the size of the rest of the arm
    [WristHolder.SLDPRT]
2025-06-27 Finished the bearing holder
    [LimitSideBearingHolder.SLDPRT]
2025-06-27 Changed the screw hole locations to match the wrist holder
    [MotorSideBearingHolder.SLDPRT]
2025-06-27 Edited sketch1
    [InnerShaft.SLDPRT]
2025-06-27 Created the wrist file
    [Wrist.SLDPRT]
2025-06-27 Added another sketch to allow for proper mating in the assembly
    [WristMotorMount.SLDPRT]
2025-06-27 Created the bearing extrusions and the general frame still need to create hand screw holes
    [Wrist.SLDPRT]
2025-06-27 Checked the size of the hole of the shaft for the motor
    [InnerShaft.SLDPRT]
2025-06-27 Created a sketch to mount the motor mount to the bearing holder
    [MotorSideBearingHolder.SLDPRT]
2025-06-27 Increased the height to allow for a full 180 degrees rotation on the elbow joint
    [LimitSideBearingHolder.SLDPRT]
2025-06-27 Added mounting holes for the hand
    [Wrist.SLDPRT]
2025-06-27 Removed the annoying warning that it was giving because of the fillet
    [InnerBearingShaftShoulder.SLDPRT]
2025-06-28 Removed the key for the mounting to cout down on the length of the lower arm
    [ElbowJoint.SLDPRT, UpperHalfOfForearm.SLDPRT]
2025-06-28 Created the screw holes for the limit switch hitter
    [Wrist.SLDPRT]
2025-06-28 Created the limit switch holder
    [LimitSwitchHitterForWrist.SLDPRT]
2025-06-28 Added some sketches to mate the wrist and its limit switch hitter
    [Wrist.SLDPRT]
2025-06-28 Rebuilt the assembly according to all of the new changes
2025-06-28 Replaced old stepper motor models with the models that have the optical encoders
    [23HS22-2804D-HG50-AR3.STEP, 23HS22-2804S-HG100.STEP]
2025-06-28 Made the shoulder lock also couple on the motor shaft
    [ShoulderLock.SLDPRT]
2025-06-28 Shrunk the motor shaft coupler to fit better
    [InnerBearingShaftTOBECNCed.SLDPRT]
2025-06-28 Added the new motors into the assembly
2025-06-28 Made the wrist a bit slimmer
    [Wrist.SLDPRT]
2025-06-28 Shrunk the length of the wrist bearing holders by 2cm since the wrist is slimmer
    [LimitSideBearingHolder.SLDPRT, MotorSideBearingHolder.SLDPRT]
2025-06-28 Made the thread reach the end of the hole instead of being a blind thread
    [OuterBearingShaft.SLDPRT]
2025-06-29 Moved the shoulder lock to its proper folder
    [ShoulderLock.SLDPRT]
2025-06-29 Renamed the file to not include the CNC part and changed the diameter of the shaft to better fit the bearing
    [InnerBearingShaft.SLDPRT, InnerBearingShaftTOBECNCed.SLDPRT]
2025-07-01 Increased diameter of mount by .05mm to fit the bearing in a bit easier
    [ShoulderMount.SLDPRT]
2025-07-02 Made some screw holes for the bearing lock
    [OuterBearingShaft.SLDPRT]
2025-07-02 Made the bearing lock file
    [ShoulderRotBearingLock.SLDPRT]
2025-07-02 FInished the bearing lock for the shoulder rotation
    [ShoulderRotBearingLock.SLDPRT]
2025-07-03 Changed the diameter of the central hole to account for the new 0.6mm nozzle
    [BeltTensionerForShoulderRot.SLDPRT]
2025-07-03 Increased the distance between the two gears for the new 1:2 gear ratio
    [OuterBearingShaft.SLDPRT]
2025-07-03 Moved the tensioner
    [OuterBearingShaft.SLDPRT]
2025-07-03 Finished changing the gear and checking if the belt engages with all teeth
    [GearForMotorShoulderRot.SLDPRT]
2025-07-03 Switched out the wrong bearing link for the shoulder rot
    [BOM.xlsx]
2025-07-03 Finished new tensioner
    [OuterBearingShaft.SLDPRT]
2025-07-03 Finished the the shoulder lock mounting system
    [OuterBearingShaft.SLDPRT]
2025-07-03 Checked the distance betweeen the two holes
    [BeltTensionerForShoulderRot.SLDPRT]
2025-07-03 Made the lock fit more snug to the corrected bearing
    [ShoulderRotBearingLock.SLDPRT]
2025-07-03 Rebult assembly with all new changes
2025-07-03 Pushed the new out bearing shaft part
    [OuterBearingShaft.SLDPRT]
2025-07-03 Rounded out the corners
    [ShoulderRotBearingLock.SLDPRT]
2025-07-03 Rebuilt the assembly with the new changes
2025-07-04 Increased the diameter of the shaft to fit the bearing better
    [InnerBearingShaftShoulder.SLDPRT]
2025-07-04 Increased the diameter of the hole to fit the bearing better
    [OuterBearingShaft.SLDPRT]
2025-07-04 Changed the diameter of the bearing hole to account for the tolerance on for the 3d printer
    [OuterBearingShaft.SLDPRT]
2025-07-05 Fixed the price typo for the shoulder elbow bearing
    [BOM.xlsx]
2025-07-05 Changed the bearing lock diameter to be larger
    [ShoulderRotBearingLock.SLDPRT]
2025-07-05 Created the limit switch thread for all the limit switches
    [LimitSwitchThread.SLDPRT]
2025-07-05 Made the file for hte limit switch mount on the elbow
    [LimitSwitchMount.SLDPRT]
2025-07-05 Made threaded holes for the limit switch mount
    [ElbowJointHolderSLDPRT.SLDPRT]
2025-07-06 Removed limit switch mount because it would be better to attach the mount directly and not mount it on
    [LimitSwitchMount.SLDPRT]
2025-07-06 Made the limit switch hitter longer to reach the limit switch
    [NonMotorElbowCap.SLDPRT]
2025-07-06 Added the limit switch mount directly to the part
    [ElbowJointHolderSLDPRT.SLDPRT]
2025-07-06 Rebuilt the assembly for all new changes
2025-07-06 Created a part to lock the top bearing in place for the shoulder rot
    [TopBearingLock.SLDPRT]
2025-07-06 Changed the diameter of the inner bearing and outer bearing mounts to match the tolerences for the 3d printer
    [ElbowJointHolderSLDPRT.SLDPRT]
2025-07-07 Added a hole in the center of the lock and reduced the lock extrusion by 1mm
    [TopBearingLock.SLDPRT]
2025-07-07 Added the top bearing lock to the assembly
2025-07-08 Removed the fillet that was stopping the elbow holder from going onto the inner bearing
    [InnerBearingShaftShoulder.SLDPRT]
2025-07-08 Threaded the holes of the motor cap
2025-07-09 Replaced the arduino with the Teensy and updated the buy status of some components
    [BOM.xlsx]
2025-07-11 Forgot to add the 5mm fillet on the mounting holes
    [UpperHalfOfForearm.SLDPRT]
2025-07-11 Made a limit switch mount for axis 4
    [BottomHalfOfForearm.SLDPRT]
2025-07-11 Created and made a part to be the limit switch hitter for J4
    [LimitSwtichHitterJ4.SLDPRT]
2025-07-11 Viewed the sketch for the wrist mounting screw holes
    [WristHolder.SLDPRT]
2025-07-11 Created the file for the limit swtich mount for J5
    [LimitSwitchMountJ5.SLDPRT]
2025-07-11 Removed the limit switch mount in order to just have the mount on the hand mount
    [LimitSwitchMountJ5.SLDPRT]
2025-07-11 Added the limit switch mount for J5
    [LimitSideBearingHolder.SLDPRT]
2025-07-11 Added fillets to limit switch mount
    [BottomHalfOfForearm.SLDPRT]
2025-07-11 Increased the distance between the motor mounting holes from 33 to 38 to account for the screw bolt head size
    [MotorSideBearingHolder.SLDPRT, WristMotorMount.SLDPRT]
2025-07-11 Changed the location of the hand screw mounting holes to not hit the limit switch mount for J5
    [Wrist.SLDPRT]
2025-07-11 Rebuilt the exoskeleton assembly for new changes and added the lower forearm back to the assembly because I accidently deleted it
2025-07-11 Shrunk the keyshaft and motor shaft hole to fit better
    [GearForMotorShoulderRot.SLDPRT]
2025-07-11 Adjusted the motor shaft hole to fit the motors shaft better and fixed how two parts of the shaft were different lengths
    [InnerBearingShaft.SLDPRT]
2025-07-11 Adjusted the motor shaft hole to fit the motors shaft better
2025-07-11 Viewed the motor shaft sketch
    [GearForMotorShoulderRot.SLDPRT]
2025-07-11 Shrunk the length of the elbow to not take up a lot of filament and weight. And to also make it look better
    [ElbowJoint.SLDPRT]
2025-07-11 Rebuilt assembly according to new changes
2025-07-11 Changed the size of the inner lip to not only fit the outer bearing but also to take the bearing out easier as well
    [OuterBearingShaft.SLDPRT]
2025-07-12 Changed the size of the motor shaft hole to better fit the motor shaft
    [GearForMotorShoulderRot.SLDPRT]
2025-07-12 Viewed the sketch of the gear to measure its diameter
    [GearForMotorShoulderRot.SLDPRT]
2025-07-12 Changed the length of the motor extrusion by 9.27mm to make it easier to fit the motor and tension the belt
    [OuterBearingShaft.SLDPRT]
2025-07-13 Created a part to go outside the bearing of the tensioner to make it bigger
    [OuterTensionerRing.SLDPRT]
2025-07-13 Shrunk the gear OD by 0.05in to engage with the belt much better
    [GearForShaftShoulderRot.SLDPRT]
2025-07-13 Changed the shaft hole size to fit the motor shaft better
    [InnerBearingShaft.SLDPRT]
2025-07-13 Viewed the motor shaft hole sketch
    [GearForMotorShoulderRot.SLDPRT]
2025-07-19 Created the mount and inital extrusion for the hands inner frame
    [Hand.SLDPRT]
2025-07-19 Made the mounting holes for bearings and the inner shaft for the two fingers
    [Hand.SLDPRT]
2025-08-03 Changed the diameter of the tensioner and added an outer ring to keep the belt from coming out of tension
    [OuterTensionerRing.SLDPRT]
2025-08-18 Changed the distance between gears to make the belt tighter since i may have broke my already printed version
    [OuterBearingShaft.SLDPRT]
2025-08-29 Made the screw threads smaller beacause the longer threads added too much frictoin, M5 bolts are too weak and I managed to strip the screw and now I have to reprint everything.
    [MotorElbowCap.SLDPRT]
2025-08-29 Made the M10 bolt holes higher so it wont interfer with the inner shaft's fillet
    [ElbowJointHolderSLDPRT.SLDPRT]
2025-09-02 Changed the diameter of the holes on the cap because it was originally for the threaded holes but I made those smaller than 2.5 but because I want it to be unthreaded I must be 2.75
    [MotorElbowCap.SLDPRT]
